flystar233/keyborad/README.md

# BLE Keybrick —— ESP32-C3 智能桌面小键盘

一块 5 键蓝牙快捷键盘的固件。连上电脑或手机后，5 个键发送可切换的快捷键组合，
另外带 OLED 状态屏、5 颗 RGB 灯和锂电池供电。

- **蓝牙 HID 键盘**：免驱，支持普通快捷键和媒体键（音量、播放/暂停等）；基于 NimBLE 协议栈，
  配对信息掉电保存，键盘重启、电脑重启或睡眠唤醒后自动回连
- **5 组键位预设**：随时切换，掉电保存；用本地网页就能改键（USB 或蓝牙都行），不用重新烧录
- **蓝牙串口（NUS）**：不插线也能改键、推送 Claude Code 状态，和 USB 串口用同一套命令
- **OLED 状态屏**（128×32）：电池电量 + 电压、蓝牙状态、按键提示
- **5 颗 WS2812B 灯**：6 种灯效，按键反馈，连接 / 低电状态提示
- **蜂鸣器**：开机 / 连接 / 断开 / 确认提示旋律，按键音，内置彩蛋音乐，三档音量开关
- **锂电池**：电量按放电曲线换算，低电提醒，TP4056 充电
- **Claude Code 状态灯**：电脑上的 Claude Code 在思考、跑工具、等你操作、做完了，键盘屏幕 / 灯 / 蜂鸣器实时提示

硬件依据：原理图 `Schematic1` / `Board1` V1.0（嘉立创 EDA）。许可证：[GPL-3.0](LICENSE)。

---

## 目录

1. [快速上手](#1-快速上手)
2. [按键操作](#2-按键操作)
3. [屏幕](#3-屏幕)
4. [灯效](#4-灯效)
5. [电池](#5-电池)
6. [Claude Code 状态](#6-claude-code-状态)
7. [编译与烧录](#7-编译与烧录)
8. [自定义](#8-自定义)
9. [串口诊断命令](#9-串口诊断命令)
10. [故障排查](#10-故障排查)
11. [硬件与引脚](#11-硬件与引脚)
12. [代码结构](#12-代码结构)
13. [致谢](#13-致谢)
14. [许可证](#14-许可证)

---

## 1. 快速上手

1. **上电**：5 颗灯依次亮 红 → 绿 → 蓝 → 白（自检，约 1 秒），OLED 亮起。
2. **等待配对**：5 颗灯**黄色明暗呼吸** = 正在广播。
3. **配对**：在电脑 / 手机的蓝牙设置里找到 **`ESP32-C3 Keybrick`** 并连接。
4. **连上后**：蜂鸣器"嘀"一声，5 颗灯**绿色闪 2 下后熄灭**，屏幕右上角蓝牙图标旁出现一个实心点。
5. **开始用**：按 K1~K5 发送当前预设的快捷键；按哪个键，哪颗灯亮一下再渐暗，
   屏幕同时显示 1.5 秒按键说明（如 `K1: Ctrl+C`）。

断开后会自动重新广播（约 3~4.5 秒后），灯回到黄色呼吸，主机可以直接回连。

---

## 2. 按键操作

板上一共 6 个按键：

| 按键 | 作用 |
| --- | --- |
| **K1~K5** | 发送当前预设的快捷键（按下立即发送；按住和普通键盘一样会连发，比如按住 Backspace 一直删） |
| **SW1 短按** | 切换灯效（见 [4. 灯效](#4-灯效)） |
| **SW1 长按 1 秒** | 进入 / 退出 **预设切换** 模式（响一声） |
| **K1 / K2（休眠时）** | 唤醒键盘，自动回连（见 [5. 电池 · 自动休眠](#自动休眠)） |

### 2.1 内置的 5 组预设

| # | 预设 | K1 | K2 | K3 | K4 | K5 |
| --- | --- | --- | --- | --- | --- | --- |
| 1 | **Daily** | Ctrl+C 复制 | Ctrl+V 粘贴 | Ctrl+Z 撤销 | PrtSc 截图 | Backspace 退格 |
| 2 | **Win Combos** | Alt+Tab | Win+D 显示桌面 | Ctrl+Alt+Del | — | — |
| 3 | **VSCode** | Ctrl+K+C 注释 | Ctrl+K+U 取消注释 | Ctrl+[ 左缩进 | Ctrl+] 右缩进 | — |
| 4 | **LCEDA**（立创 EDA） | Alt+W 布线 | Alt+V 过孔 | Alt+E 铺铜 | Alt+T 顶层 | Alt+B 底层 |
| 5 | **Media** | 音量 − | 音量 + | 播放 / 暂停 | 静音 | 下一曲 |

`—` 表示空键：按下有灯光和声音反馈，但不发送任何东西。
想改键位见 [8.1 用网页改键](#81-用网页改键)。

### 2.2 切换预设

1. **长按 SW1 1 秒**，听到"嘀"一声进入预设切换模式：5 颗灯整体偏青色，
   屏幕显示 `> Config Preset` 和当前预设名，下方每 2 秒滚动显示各键说明。
2. **K1 / K2** 上一组 / 下一组（按住可以连续翻页）。翻到的预设**立即生效**，可以直接试按。
3. **K3 确认**：保存到 flash（断电不丢），"叮咚"一声回到正常模式。

预设切换模式下另外两个键：

| 键 | 作用 |
| --- | --- |
| **K4** | 声音档位：全开 → 关按键音 → 静音 → 全开（立即保存，见 [2.3](#23-声音)） |
| **K5** | 播放彩蛋音乐，《欢乐颂》（约 21 秒）《卡农》快速段（约 22 秒）轮流；放的时候再按一下停止 |

不确认就退出（再次长按 SW1，或串口 `n`），会**恢复成进来之前的预设**。
预设切换模式下按键**不会**向电脑发送快捷键。

### 2.3 声音

| 场合 | 声音 |
| --- | --- |
| 开机 | do-mi-sol-do 上行 |
| 蓝牙连上 / 断开 | 上扬两音 / 下沉三音 |
| 进入预设切换 / 不确认退出 | 短促上行 / 短促下行 |
| 确认预设 | "叮咚" |
| 按 K1~K5 发送快捷键 | 很短的"嗒" |
| 预设切换模式按 K5 | 彩蛋音乐（见下表） |

彩蛋音乐（预设切换模式下按 K5 轮流播放，播放中再按一次停止）：

| 曲子 | 时长 | 内容 | 音域 |
| --- | --- | --- | --- |
| 《欢乐颂》 | 约 21 秒 | 完整主题四句 A - A' - B - A' | 784~1568Hz |
| 《卡农》 | 约 22 秒 | 第一小提琴声部的十六分音符快速段，放慢后完整重复两遍，收在主音 D | 587~1760Hz |

声音档位（预设切换模式按 K4 切换，屏幕第 1 行显示 `Sound:ON / QUIET / OFF`）：

| 档位 | 按键音 | 提示旋律 | 彩蛋音乐 |
| --- | --- | --- | --- |
| `ON`（默认） | ✓ | ✓ | ✓ |
| `QUIET` | — | ✓ | ✓ |
| `OFF` | — | — | — |

蜂鸣器是无源电磁式（QMB-09B-03，谐振约 2.7kHz），只能放单音旋律、音色是电子方波音。
它在 1~4kHz 最响、低于 1kHz 会稍微发闷，太高又刺耳，所以曲子都放在 600~1800Hz 左右。

改曲子都在 `src/buzzer.cpp`：

- **快慢**：`ODE_Q`（欢乐颂，330）和 `CANON_Q`（卡农，600）是四分音符的毫秒数，越大越慢、曲子也越长。
- **卡农只放一遍**：删掉 `kCanon` 里第二个 `CANON_PASSAGE,`（约 13 秒）。
- **加新曲子**：照 `kOdeToJoy` 的格式写一个 `{频率, 毫秒}` 数组，再加进 `kSongs[]`，K5 就会轮到它。

---

## 3. 屏幕

### 正常模式

平时只有顶部一行状态，其余留空：

```
[电池] 3.87V                              [蓝牙]●

 K1: Ctrl+C          ← 按键时显示 1.5 秒
Claude Bash      1:23 ← Claude Code 状态（见 6. Claude Code 状态）
```

| 元素 | 说明 |
| --- | --- |
| 电池图标（左上） | 5 档填充表示电量；**空心** = 未启用电池检测（见 [5. 电池](#5-电池)） |
| 电压（图标右侧） | 如 `3.87V`，每 10 秒更新；读不到时显示 `-.--V`；未启用电池检测时不显示 |
| 蓝牙图标（右上） | 只有图标 = 等待配对；图标 + 右侧实心点 = 已连接 |
| 按键提示（第 3 行） | 按 K1~K5 时显示键名和功能，1.5 秒后消失 |
| Claude 状态（第 4 行） | 电脑上 Claude Code 的运行状态 + 本轮用时；没在用时不显示 |

### 预设切换模式

第 1 行 `> Preset  Sound:ON`（带当前声音档位），第 2 行 `< 预设名 >`，第 3、4 行轮流显示 5 个键的说明（每 2 秒滚动）。

### 息屏

- 无操作 20 秒变暗，30 秒关屏；按任意键（包括 SW1）唤醒。
- 低电时强制变暗省电。

---

## 4. 灯效

### 状态提示（优先于灯效模式）

| 状态 | 灯 |
| --- | --- |
| 上电自检 | 红 → 绿 → 蓝 → 白，各 250ms |
| 未连接蓝牙（上电、广播中、断线后） | 5 颗一起**黄色明暗呼吸** |
| 刚连上蓝牙 | 5 颗一起**绿色闪 2 下**，然后进入当前灯效 |
| 预设切换模式 | 整条偏**青色** |
| 电池低电 | 整条**暗红闪烁**（最高优先级） |

### 灯效模式（6 种）

**短按 SW1** 切换到下一种（松开时生效）。上电默认第 1 种，不保存。

| # | 名称 | 效果 |
| --- | --- | --- |
| 1 | `KEYS`（默认） | 全灭；按下的键对应的灯**亮一下再渐暗** |
| 2 | `WHITE` | 白色常亮 |
| 3 | `BREATHE` | 青蓝色整条呼吸 |
| 4 | `RAINBOW_CHASE` | 炫彩跑马灯：一颗亮点来回跑、边跑边换色，带拖尾 |
| 5 | `RAINBOW` | 彩虹流动：整条色轮缓慢平移 |
| 6 | `KEYS_COLOR` | 缤纷按键：全灭；按键时亮一个随机颜色再渐暗 |

- **按键反馈**在所有灯效下都有：平时是白色，`WHITE` 灯效下为青色，`KEYS_COLOR` 下为随机色。
- 未连接蓝牙时切换灯效，会先**预览新灯效 3 秒**再回到黄色呼吸。
- 切换灯效不会改变屏幕内容。
- **省电**：5 颗灯全灭超过 1 分钟，自动切断灯珠电源（GPIO21）；之后一有要亮的灯（按键、连接状态、切灯效等）自动重新上电，只多 5ms 延迟。

---

## 5. 电池

### 显示

- **电量**按锂电池放电曲线查表换算（不是线性），参考点：

  | 电压 | 4.20V | 4.00V | 3.87V | 3.80V | 3.75V | 3.70V | 3.60V | 3.40V |
  | --- | --- | --- | --- | --- | --- | --- | --- | --- |
  | 电量 | 100% | 80% | 60% | ≈43% | ≈27% | ≈14% | 5% | 0% |

  锂电池的"3.7V 标称"是整个放电过程的平均电压，不代表还剩一半电。
  空电点取 3.40V：板上 LDO 输出 3.3V，电池再低，系统供电就不稳了。

- **低电**：低于 3.50V 进入（灯暗红闪、屏幕变暗），回升到 3.60V 以上才解除。
- 电量同时通过蓝牙电池服务上报给主机。

### 自动休眠

电源开着但**蓝牙 1 分钟都没连上、也没人按键**时，屏幕提示 `Sleeping...` 后进入深度睡眠：
灯、屏幕、蓝牙全关，省得忘了拨电源开关时一直亮灯耗电。

- **按 K1 或 K2 唤醒**，醒来自动回连电脑（不放开机音、不跑灯效自检，回连更快）。
  只有这两个键能唤醒：ESP32-C3 只有 GPIO0~5 能把芯片从深度睡眠里叫醒。
- 连着蓝牙、或者 USB 插在电脑上（改键、看日志时）不会睡；只插充电器不算，照样会睡（睡着也照常充电）。
- 时间和开关在 `include/board_config.h`：`AUTO_SLEEP_MS`（默认 60 秒）、`AUTO_SLEEP_ENABLED`。

### 充电时读数偏高

电压是在 BAT+ 上测的。充电时充电电流会在电池内阻上产生额外压降，
所以显示的电压和电量**偏高**（比如静置 3.70V 的电池充电时可能显示 3.80V 左右，接近充满时停在约 4.2V）。
拔掉充电线静置一会儿后的读数才准确。

### 启用 / 停用电池检测

TP4056 在**没装电池**时也会让 BAT+ 一直保持 4.2V，软件无法区分"没装电池"和"已充满"。
所以用开关明确告诉固件有没有装电池：

| 方式 | 用法 |
| --- | --- |
| `include/board_config.h` | `#define BATTERY_PRESENT 1`（装了电池，默认）/ `0`（没装） |
| 运行时 | 串口发 `v` 来回切换（重启后恢复为上面的设定） |

停用时不采样，电池图标为空心、不显示电压，也不会误报低电。

### 校准

如果显示的电压和万用表实测不一致，调 `board_config.h` 里的 `BATTERY_CAL`：
`显示电压 = ADC 读数 / 0.5 × BATTERY_CAL`。

---

## 6. Claude Code 状态

在电脑上用 [Claude Code](https://claude.com/claude-code) 时，键盘会实时显示它在干什么，
让你不用一直盯着终端：

| Claude Code 在 | 屏幕第 4 行 | 灯 | 声音 |
| --- | --- | --- | --- |
| 刚打开 | `Claude ready` | — | — |
| 思考 | `Claude thinking  0:12`（本轮已用时） | — | — |
| 调用工具 | `Claude Bash 0:15`（工具名） | — | — |
| **等你操作**（批准权限、回答问题、确认计划） | `Claude NEED YOU` 闪烁 | **K5 那颗灯橙色闪** | 嘀嘀嘀 |
| **做完了** | `Claude done 2:47`（本轮总用时） | K5 那颗灯绿闪 3 下 | 三音上行 |
| 你中途打断（Esc / 停止 / 拒绝权限并打断） | 回到 `Claude ready` | 灯停 | — |
| 关闭 | 不显示 | — | — |

- "做完了"会保留 10 分钟，之后变回 `Claude ready`。
- 声音受声音档位控制（[2.3](#23-声音)），`OFF` 档不响。
- 只在正常模式的屏幕上显示；状态变成"等你 / 做完"时会自动点亮屏幕。

### 工作原理

Claude Code 的 **hooks**（事件钩子）在每次提交提示词、调用工具、请求权限、完成时，
运行 `tools/claude_status.py`。脚本把事件换成一行 `@CLAUDE <状态> [工具名]`，
发给键盘：**插着 USB 线就走 USB 串口，没插线就走蓝牙**。工具调用的钩子在后台运行，**不会拖慢 Claude Code**；
USB 和蓝牙都找不到键盘时脚本直接安静退出。

**走蓝牙时**：第一次需要时脚本会在后台起一个"蓝牙桥"小进程，一直连着键盘的蓝牙串口（NUS），
之后每个钩子只是把一行交给它，约 0.2 秒送达（改键网页的「蓝牙连接」在电脑上也走这个桥，本机端口 47815）。桥刚启动、还没连上时（约 5 秒）只记住最新一条，
连上立刻补发。断开会自动重连，2 小时没有消息自己退出。蓝牙需要 Python 库 `bleak`（安装脚本会自动装）。

### 安装（任何一台电脑，一条命令）

支持 Windows / macOS / Linux。需要：装了 Claude Code、有 Python 3.7+，键盘用 USB 数据线连着这台电脑，
**或者**已经和这台电脑蓝牙配对。

1. 把 `tools/claude_status.py` 和 `tools/install_claude_status.py` 这两个文件拷到那台电脑（放同一个目录）。
2. 运行：

   ```bash
   python install_claude_status.py          # macOS / Linux 上可能是 python3
   ```

安装脚本会：

1. 检查 pyserial（USB 用，必需）和 bleak（蓝牙用，可选），没有就自动安装；
2. 把 `claude_status.py` 复制到 `~/.claude/keybrick/`（装完后那两个文件可以删掉）；
3. 把 7 个钩子合并进 `~/.claude/settings.json`：只增删本工具自己的条目，其它设置和别的钩子原样保留，
   改之前备份成 `settings.json.bak-keybrick`，重复运行不会重复添加；
4. 给键盘发一遍测试状态（thinking → Test → NEED YOU → done），确认能收到。

装完 Claude Code 不用重启，下一次事件就生效。

| 命令 | 作用 |
| --- | --- |
| `python install_claude_status.py` | 安装或更新（改了 `claude_status.py` 后重新运行一次即可） |
| `python install_claude_status.py --test` | 只发一遍测试状态 |
| `python install_claude_status.py --uninstall` | 卸载：删掉钩子和 `~/.claude/keybrick/` |

钩子在 `settings.json` 里长这样（安装脚本自动写，一般不用手动改）：

```json
"Stop": [{ "hooks": [{ "type": "command", "command": "<python 路径>",
                       "args": ["~/.claude/keybrick/claude_status.py"], "timeout": 15 }] }]
```

工具事件（`PreToolUse` / `PostToolUse`）额外带 `"async": true`、`"matcher": "*"`。

- **手动测试**：`python ~/.claude/keybrick/claude_status.py work`（也可以是 `tool Bash` / `wait` / `done`），会打印键盘的回复。
- **指定串口**：默认自动找乐鑫（VID 0x303A）的串口；有多块板子时设环境变量 `KEYBRICK_PORT`
  （Windows 如 `COM3`，macOS 如 `/dev/cu.usbmodem1101`）。
- **Linux 串口权限**：`sudo usermod -aG dialout $USER`，重新登录后生效。
- **暂时关掉**：Claude Code 里输入 `/hooks` 可以查看、停用这些钩子。
- **注意**：改键网页或串口监视器开着时 USB 串口被占用，这期间会自动改走蓝牙（如果配对过）。
- **只用 USB**：设环境变量 `KEYBRICK_BLE=0` 关掉蓝牙。
- **打断检测**：Claude Code 被打断时不会触发"完成"事件，所以每次提交提示词时会在后台起一个小进程，盯着这个会话的记录文件，看到打断记录就把键盘切回 `Claude ready`；这一轮正常结束或下一轮开始时它自动退出。
- **排查**：每次发送都记在临时目录的 `keybrick_claude.log`（Windows 是 `%TEMP%\keybrick_claude.log`），
  记录事件、状态、走的通道（`COMx` 或 `ble`）、是否被丢弃、耗时；蓝牙桥的连接 / 断开也记在这里。
- **顺序保证**：多个钩子进程按"进程创建时刻"排队发送，晚到的旧消息直接丢弃；
  "开始 / 提交 / 等你 / 完成 / 关闭"这几个钩子同步运行，保证一定送到，工具事件在后台运行不拖慢 Claude Code。

---

## 7. 编译与烧录

### 环境

- [PlatformIO](https://platformio.org/)（VS Code 插件或命令行）
- 工具链：`espressif32@6.10.0`（arduino-esp32 2.0.17），首次编译会自动下载
- 蓝牙库：[NimBLE-Arduino](https://github.com/h2zero/NimBLE-Arduino) 2.x（`platformio.ini` 的 `lib_deps`），首次编译会自动下载
- 板子用 USB-C 直接连电脑（芯片内置 USB-Serial/JTAG，无需 USB 转串口芯片）

### 命令（在项目根目录执行）

```powershell
# 只编译
pio run

# 编译 + 烧录（自动找串口）
powershell -NoProfile -ExecutionPolicy Bypass -File tools\flash.ps1

# 指定串口 / 跳过编译
powershell -NoProfile -ExecutionPolicy Bypass -File tools\flash.ps1 -Port COM16
powershell -NoProfile -ExecutionPolicy Bypass -File tools\flash.ps1 -Port COM16 -SkipBuild

# 看日志（115200）
pio device monitor --port COM16 --dtr 0 --rts 0
```

如果 `pio` 不在 PATH 里，用完整路径 `$env:USERPROFILE\.platformio\penv\Scripts\pio.exe`。

> **必须用 `tools\flash.ps1` 烧录，不要用 `pio run -t upload`**：后者在这块板上会报
> `Wrong boot mode detected (0xd)`（固件运行时 esptool 默认的复位方式进不了下载模式，脚本改用 `--before usb_reset`）。
>
> **看日志必须带 `--dtr 0 --rts 0`**，否则打开串口会让芯片复位或停在下载模式。

**进不了下载模式时**（极少见）：按住 **BOOT** → 点一下 **RESET** → 松开 BOOT，
然后执行 `tools\flash.ps1 -SkipReset`。

### 资源占用

RAM 约 8%（26KB / 320KB），Flash 约 41%（526KB / 1280KB）。
蓝牙协议栈换成 NimBLE 后 Flash 少了一半左右（之前用 Bluedroid 约 79%），加功能的余量很充足。

---

## 8. 自定义

### 8.1 用网页改键

`tools/keymap.html` 是一个本地网页，通过 USB 或蓝牙直接读写键盘上的 5 组预设，**不用重新烧录**。

1. 用 **Chrome 或 Edge** 双击打开 `tools/keymap.html`（其它浏览器不支持 Web Serial / Web Bluetooth）。
2. 二选一连接键盘：
   - **USB 连接**：插上 USB 线，**关掉** PlatformIO 串口监视器等占用串口的程序，点右上角「USB 连接」，
     在列表里选 `USB JTAG/serial debug unit`（或带 `COMx` 的那一项）。
   - **蓝牙连接**：键盘先和这台电脑配对好（正常当键盘用的状态就行），点右上角「蓝牙连接」。
     电脑上要经过本机的**蓝牙桥**（和 Claude Code 状态推送是同一个后台进程）：装了状态推送的话没插线时会自动启动；
     也可以手动运行 `python tools/claude_status.py --ble-bridge`（需要 `pip install bleak`）。
     安卓手机上的 Chrome 直接用浏览器自带的蓝牙，在列表里选 `ESP32-C3 Keybrick`。
     > 为什么电脑上不直接用浏览器的蓝牙：Windows 把键盘当成 HID 设备占用着，浏览器的 Web Bluetooth
     > 连它时会强制重新查询服务列表，这一步会失败（报找不到 `6e400002...` 特征值）。
3. 顶栏状态会显示"已连接（USB）"或"已连接（蓝牙）"。
4. 页面自动读出 5 组预设，并显示键盘当前正在用的那一组。点模型左上角的圆钮 **1~5**
   切换预设，键盘会同步切过去（圆钮下方的短横线标出键盘当前用的是哪组）。选好一组后可以修改：
   - **预设名**（≤19 个英文字符）和**类型**（普通快捷键 / 媒体键）
   - 每个键的**修饰键**（Ctrl / Shift / Alt / Win）+ **按键**（最多两个，如 Ctrl+K+C）；
     也可以点 **录制**，然后直接在电脑键盘上按组合键
   - 媒体键：音量、播放 / 暂停、上一曲 / 下一曲、静音、计算器、浏览器后退等
   - 按键时 OLED 上显示的说明按组合键自动生成（如 `Ctrl+Shift+S`、`Volume +`），不用单独填
5. 点 **写入键盘**：5 组一起写入并保存到 flash，立即生效，断电不丢。

其它按钮：**恢复出厂预设**、**导出到文件 / 从文件导入**（备份或分享键位）。
有改动但还没写入的预设，对应圆钮右上角会有一个橙色圆点；右上角「写入键盘」按钮上显示未写入的组数。

> - 屏幕字体只有英文字符，预设名和说明里不能用中文。
> - 有些组合键会被浏览器或系统先拦截（如 Ctrl+W、Alt+Tab、Win+D），录制不到；用下拉框手动选即可。
> - 按键码只能用标准键盘区和小键盘（F1~F12 以内），F13 以上键盘发不了。
> - 如果双击打开后点"连接键盘"没反应，可以在 `tools` 目录下运行 `python -m http.server 8000`，
>   再用浏览器打开 `http://localhost:8000/keymap.html`。

### 8.2 在源码里改出厂预设

出厂预设（以及"恢复出厂预设"恢复成的样子）在 `src/settings.cpp` 的 `kDefaultPresets[]`。
每个键是一条 8 字节的 HID 键盘报文：

```
{ 修饰键, 0x00, 键码1, 键码2, 0x00, 0x00, 0x00, 0x00 }
```

| 修饰键（可相加） | 值 |
| --- | --- |
| 左 Ctrl | `0x01` |
| 左 Shift | `0x02` |
| 左 Alt | `0x04` |
| 左 Win / Cmd | `0x08` |

常用键码：`A`~`Z` = `0x04`~`0x1D`，`1`~`9` = `0x1E`~`0x26`，`0` = `0x27`，
Enter `0x28`，Esc `0x29`，Backspace `0x2A`，Tab `0x2B`，空格 `0x2C`，
F1~F12 = `0x3A`~`0x45`，Delete `0x4C`，方向键 → ← ↓ ↑ = `0x4F`~`0x52`。
完整列表见 USB HID Usage Tables 的 Keyboard/Keypad Page (0x07)。

例：Ctrl+Shift+T = `{ 0x03, 0x00, 0x17, 0x00, 0x00, 0x00, 0x00, 0x00 }`。

每组预设还要填：
- `name`：预设名（≤19 字符，显示在屏幕上）
- `keyDesc`：5 个键的说明（每个 ≤15 字符，按键时显示在屏幕上）
- 全 0 的报文 = 空键

**媒体键**：把预设最后的 `isMedia` 设为 `true`，每个键第 0 字节填媒体键位：
`MEDIA_VOLUME_UP` / `MEDIA_VOLUME_DOWN` / `MEDIA_PLAY_PAUSE` / `MEDIA_MUTE` /
`MEDIA_NEXT_TRACK` / `MEDIA_PREV_TRACK` / `MEDIA_STOP`（定义在 `include/settings.h`）。
一组预设要么全是普通键，要么全是媒体键。

增减预设数量时，同步改 `include/settings.h` 的 `PRESET_COUNT`。

### 8.3 常用参数

| 参数 | 位置 | 默认 |
| --- | --- | --- |
| 灯珠亮度 `LED_BRIGHTNESS`（0~255） | `include/board_config.h` | 96 |
| 蓝牙设备名 `BLE_DEVICE_NAME` | `include/board_config.h` | `ESP32-C3 Keybrick` |
| 是否装了电池 `BATTERY_PRESENT` | `include/board_config.h` | 1 |
| 低电阈值 `BAT_LOW_V` / `BAT_LOW_RELEASE_V` | `include/board_config.h` | 3.50V / 3.60V |
| SW1 长按时间 `MODE_HOLD_MS` | `src/system.cpp` | 1000ms |
| 翻页连发延迟 / 间隔 | `include/buttons.h` | 450ms / 140ms |
| 变暗 / 关屏时间 | `src/system.cpp` | 20s / 30s |
| 提示旋律 / 彩蛋曲子 | `src/buzzer.cpp` | 见 [2.3 声音](#23-声音) |
| 电量曲线 `kBatCurve` | `src/battery.cpp` | 见 [5. 电池](#5-电池) |

修改引脚只需要改 `include/board_config.h`，其它文件不涉及具体引脚号。

---

## 9. 串口诊断命令

用 `pio device monitor --port COMx --dtr 0 --rts 0` 打开串口后，**单键输入，不需要回车**。
每次只按一个键：一次收到多个字符（比如粘贴一串、或带回车）会被当成杂讯丢弃，防止误触发。

| 键 | 作用 |
| --- | --- |
| `?` | 显示帮助 |
| `@...` | 网页改键、Claude 状态用的行协议（见 `src/system.cpp` 的"上位机改键协议"注释），手动一般用不到。蓝牙串口（NUS）也能发同样的命令，单键诊断命令只走 USB |
| `s` | 打印状态：模式、预设、电压 / 电量、屏幕、声音档位、灯珠电源 |
| `1`~`5` | 直接切换到第 N 组预设并保存 |
| `p` | 打印当前预设 5 个键的 HID 报文字节 |
| `n` / `c` | 切到 正常 / 预设切换 模式 |
| `v` | 切换"是否装了电池" |
| `e` / `k` | 切换下一个灯效 / 查看当前灯效和 SW1 按键状态 |
| `r` | 重跑灯珠自检（红绿蓝白） |
| `x` | 逐颗逐通道检测：每颗灯依次只亮 红 / 绿 / 蓝 / 白 |
| `o` / `f` | 灯珠电源 开 / 关（用万用表量灯珠供电时用） |
| `i` | 扫描 I2C 总线（排查屏幕不亮） |
| `d` | 屏幕探活，并冻结画面显示状态行 + 四角定位点 |
| `F` | 解除 / 恢复屏幕冻结 |
| `P` | 自动模拟 5 个键的按键提示，检查文字位置 |
| `w` | 唤醒屏幕 |
| `g` | 打印 GPIO 矩阵：每个脚当前由哪个外设驱动 |

`g` 输出中 `out_sel` 的含义：`128` = 普通 GPIO 输出，`51` = RMT（灯珠数据），
`45` = LEDC（蜂鸣器），`6` = UART0 TXD。正常时灯珠数据脚（pin1）是 `51`，灯珠电源脚（pin21）是 `128`。

> 启动日志（`=== ESP32-C3 BLE Keybrick booting ===`）只有在复位后**立刻**打开串口才看得到。
> 日志在主机没读时最多等 20ms 就丢弃，这是为了不阻塞按键和灯效。

---

## 10. 故障排查

| 现象 | 排查 |
| --- | --- |
| 烧录报 `Wrong boot mode detected` | 用 `tools\flash.ps1`，不要用 `pio run -t upload`；仍不行就手动进下载模式（见 [7](#7-编译与烧录)） |
| 串口没有任何输出 | 确认带了 `--dtr 0 --rts 0`；复位后马上打开串口；发 `?` 看有没有回应 |
| 搜不到蓝牙设备 | 灯是不是黄色呼吸（在广播）；电脑上删除旧的配对记录后重新搜索 |
| 蓝牙反复连上又断开 | 电脑上的配对记录和键盘对不上（比如从旧固件升级后）：在电脑蓝牙设置里删除 `ESP32-C3 Keybrick` 再重新添加。串口日志里会看到 `link up ... encrypted=0` 后紧跟 `link down` |
| 网页点"连接键盘"列表里没有设备 | 换一根能传数据的 USB 线；确认用的是电脑版 Chrome / Edge |
| 网页提示"打不开串口" | 串口被占用：关掉 PlatformIO 串口监视器、Arduino IDE 等 |
| 网页提示"键盘没有回应" | 固件太旧，先用 `tools\flash.ps1` 烧录最新固件 |
| 网页点「蓝牙连接」提示要启动蓝牙桥 | 运行 `python tools/claude_status.py --ble-bridge`（需要 bleak），等几秒再点；或者插线用「USB 连接」 |
| 网页提示蓝牙桥还没连上键盘 | 键盘要开着、并且已经在系统蓝牙设置里配对；刚启动的桥要几秒才连上 |
| 能连上但按键没反应 | 是否在正常模式（灯不偏青、屏幕只有状态行）；当前预设的这个键是不是空键（`p` 查看） |
| 灯全不亮 | 串口 `g`：pin21 `out_sel` 应为 `128`；量灯珠供电是否 3.3V（`o`/`f` 切换时应跟着变） |
| 只有第 1 颗灯亮 | LED1 `DO` → LED2 `DI` 之间断开（虚焊或方向） |
| 某颗灯颜色偏黄 / 偏色 | 发 `x` 逐通道检测；某个通道不亮就是那颗灯坏了或虚焊（黄色 = 蓝通道不亮） |
| 红绿颜色反了 | 改 `src/ws2812.cpp` 中 `show()` 的 `order[3] = {1,0,2}` |
| 屏幕不亮 | 串口 `i`：扫到 `0x3C` 说明屏幕在线；什么都扫不到就检查排针 3V3 / GND / SDA / SCL |
| K3 没反应 / 灯全灭 | 检查 `platformio.ini` 中 `ARDUINO_USB_CDC_ON_BOOT=1` 是否还在（K3 / GPIO20 和灯珠电源 / GPIO21 是 UART0 默认引脚，日志必须走 USB） |
| 上电时按键乱触发 / 进了下载模式 | GPIO0 / 2 / 8 / 9 是启动配置脚，上电瞬间不要按住 K1 / K2 / K5 / BOOT |
| 电压和万用表不一致 | 调 `BATTERY_CAL`（见 [5](#5-电池)） |
| 没装电池却显示 4.2V / 100% | 把 `BATTERY_PRESENT` 设为 0，或串口发 `v` |

---

## 11. 硬件与引脚

| 功能 | 引脚 | 说明 |
| --- | --- | --- |
| K1 | GPIO0 | 按下接地，内部上拉；启动配置脚 |
| K2 | GPIO2 | 按下接地，板上 10K 上拉；启动配置脚 |
| K3 | GPIO20 | 按下接地，内部上拉；同时是 UART0 RXD 默认脚 |
| K4 | GPIO7 | 按下接地，内部上拉 |
| K5 | GPIO8 | 按下接地，板上 10K 上拉；启动配置脚 |
| SW1（灯效 / 模式键） | GPIO6 | 按下接地，内部上拉 |
| WS2812B 数据 | GPIO1 | 经 100Ω 接 LED1，5 颗级联（WS2812B-2020） |
| 灯珠电源开关 | GPIO21 | AO3401 P-MOS 高边开关，**低电平导通**；灯全灭 1 分钟自动断电省电；同时是 UART0 TXD 默认脚 |
| OLED SDA / SCL | GPIO4 / GPIO5 | SSD1306 128×32，硬件 I2C 400kHz，地址 `0x3C` |
| 蜂鸣器 | GPIO10 | 经 S9013 驱动的 2.7kHz 无源蜂鸣器，高电平响 |
| 电池电压 | GPIO3 | BAT+ 经 100K/100K 分压（×0.5），只能作模拟输入 |
| BOOT | GPIO9 | 只用于进下载模式 |
| USB | GPIO18 / GPIO19 | 芯片内置 USB-Serial/JTAG，烧录和日志都走这里 |

电源：TP4056 充电（500mA），TLV75733 LDO 输出 3.3V。
外壳：3D 打印，壳体 + 盖子用 4 颗 M2×14 自攻螺丝从底部固定，见 [case/README.md](case/README.md)。
除 GPIO9（BOOT）外，所有可用引脚都已占用。

---

## 12. 代码结构

```
platformio.ini            工程配置
include/board_config.h    所有引脚与硬件参数（改硬件只改这里）
src/main.cpp              启动流程 + 主循环：蓝牙连接、报文发送、各模块调度
src/system.cpp            模式切换、按键与 SW1 事件、OLED 界面、串口诊断命令、改键协议（USB / 蓝牙两个通道）
src/buttons.cpp           K1~K5 消抖与连发（非阻塞）
src/settings.cpp          出厂预设表 + 用户预设的 NVS 读写
src/display.cpp           SSD1306 驱动：512 字节帧缓冲、6×8 字体、图标
src/led_effects.cpp       灯效与状态提示的合成，SW1 消抖
src/ws2812.cpp            WS2812B 驱动（RMT 硬件时序）+ 灯珠电源开关
src/buzzer.cpp            蜂鸣器：LEDC 硬件 PWM + 非阻塞音符播放器、提示旋律、彩蛋曲子
src/battery.cpp           电池电压采样、电量换算、低电判断
include/usb_log.h         直接写 USB-Serial/JTAG FIFO 的日志
include/display_font.h    6×8 ASCII 字库
include/display_icons.h   电池 / 蓝牙 8×8 图标（取自 u8g2 open-iconic）
lib/ble_keyboard/         BLE HID 键盘 + 媒体键 + 电池电量 + NUS 蓝牙串口（基于 NimBLE-Arduino）
tools/flash.ps1           烧录脚本
tools/keymap.html         网页改键工具（Chrome / Edge，Web Serial 或 Web Bluetooth）
tools/claude_status.py    Claude Code hook：把运行状态推给键盘（USB 优先，没插线走蓝牙桥）
tools/install_claude_status.py  一键安装 / 卸载上面这个 hook（任何电脑）
tools/verify_icons.py     图标位图校验脚本
case/build_case.py        3D 打印外壳生成脚本（参数化，见 case/README.md）
case/out/                 生成好的外壳 STL（壳体 + 盖子）
case/ref/                 底稿：v1.2f 旧版外壳 STL + PCB 图（外壳开孔位置都按它测量）
```

所有模块都是非阻塞的：主循环每轮轮询各模块后让出 1ms，不使用硬件定时器中断。

---

## 13. 致谢

- 本项目基于一个开源的 ESP32-C3 蓝牙小键盘工程重写。原工程提供了最初的思路、
  6 组键位预设、6×8 ASCII 字库（`include/display_font.h`）和 BLE HID 库（`lib/ble_keyboard/`，
  后来改用 NimBLE 重写，保留了原来的 HID 报告描述符）。代码注释里的"原工程"指的就是它。
- 电池和蓝牙图标取自 [u8g2](https://github.com/olikraus/u8g2) 附带的
  [Open Iconic](https://github.com/iconic/open-iconic) 字形。
- 网页改键使用浏览器的 [Web Serial API](https://developer.mozilla.org/docs/Web/API/Web_Serial_API)。

## 14. 许可证

本项目以 [GNU General Public License v3.0](LICENSE) 发布：可以自由使用、修改和再分发，
但基于本项目发布的修改版也必须以 GPL-3.0 开源。
