flystar233/keyborad/diag/cand2.png

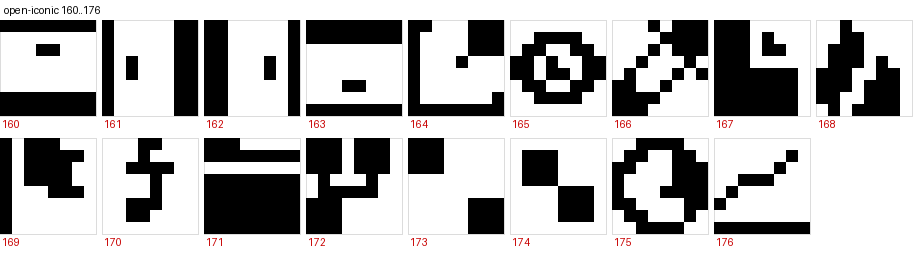
diag/cand2.png
