flystar233/keyborad/diag/cand3.png

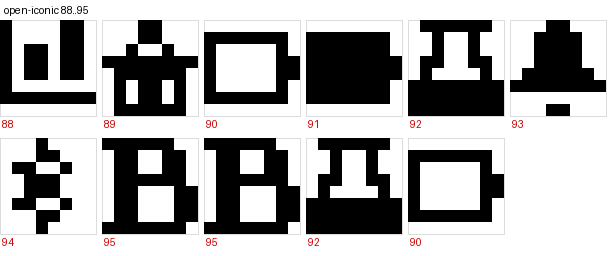
diag/cand3.png
