flystar233/keyborad/diag/candidates.png

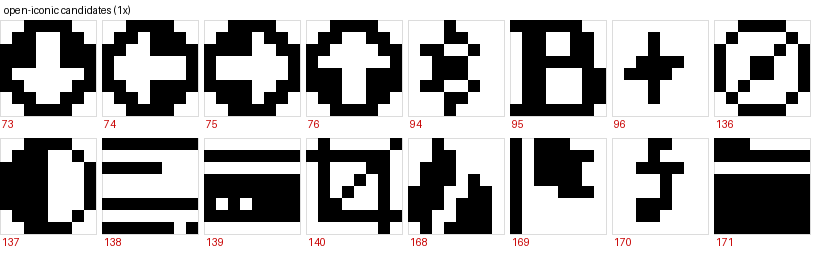
diag/candidates.png
