flystar233/keyborad/diag/T3_buzzer.png

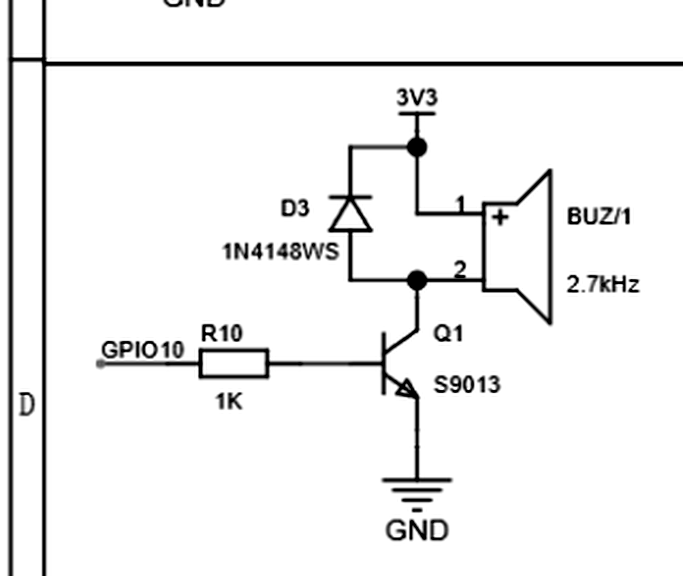
diag/T3_buzzer.png
