flystar233/keyborad/diag/T4_oled.png

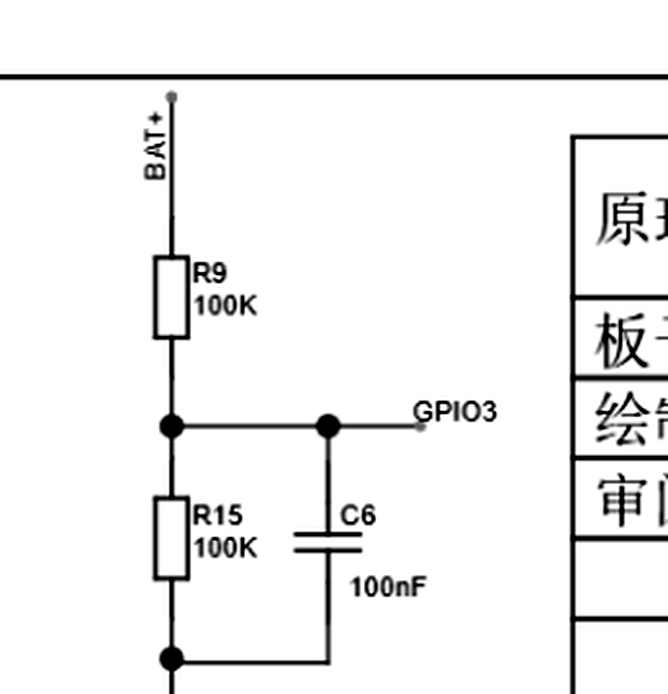
diag/T4_oled.png
