flystar233/keyborad/case/out/ESP32 BLE Keyboard v1.3 cover.stl

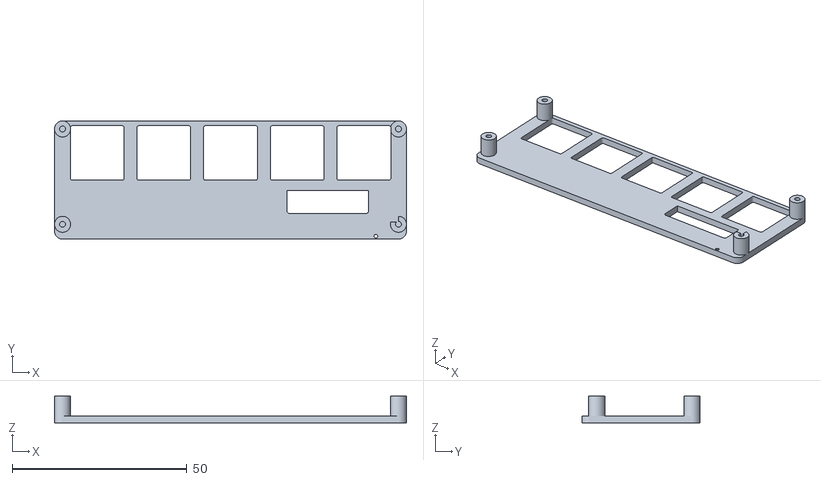
[picture p6: CAD file, 2026-10-12]
case/out/ESP32 BLE Keyboard v1.3 cover.stl
100.8 x 33.9 x 7.70
