flystar233/keyborad/case/out/ESP32 BLE Keyboard v1.3 shell.stl

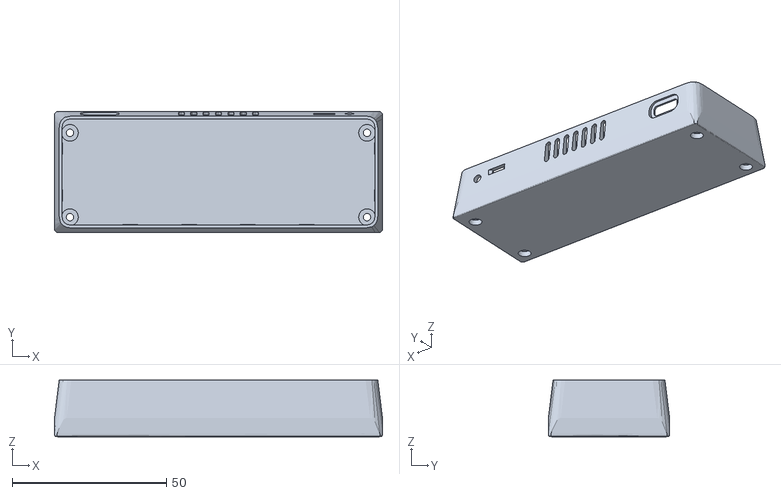
[picture p7: CAD file, 2026-10-12]
case/out/ESP32 BLE Keyboard v1.3 shell.stl
106.2 x 39.3 x 18.3
