flystar233/keyborad/case/ref/PCB_PCB1_2026-10-11.pdf

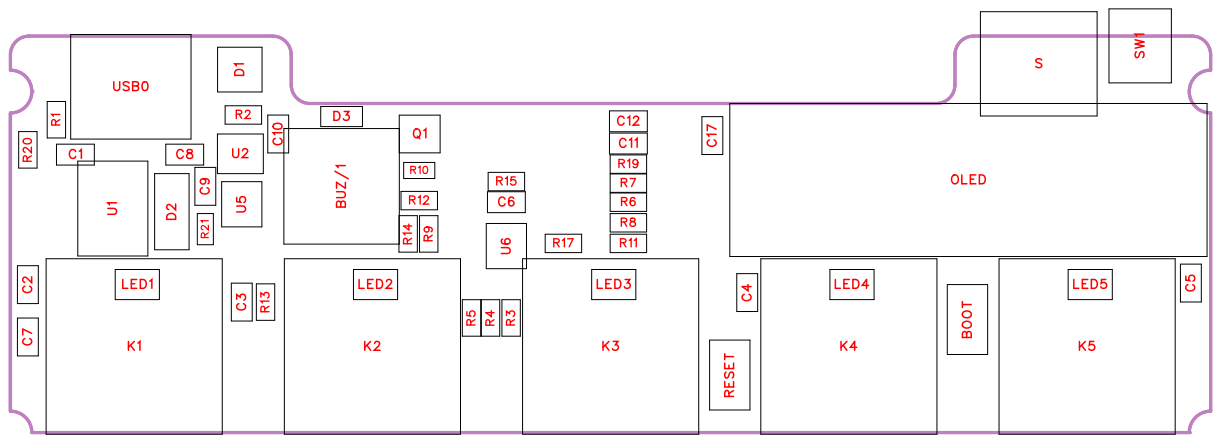
[picture p8: page 1]

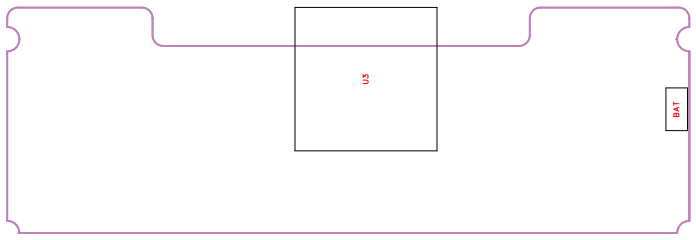
[picture p9: figure]
BAT

No. | Quantity | Comment | Designator | Footprint | Value | Manufacture r Part | Manufacture r | Supplier Part | Supplier
1 | 1 | 2.54-1*2PÍ | BAT | HDR-TH_2P-P 2.54-V-F | | 2.54-1*2PÍ | BOOMELE(ZF¾) Tj | T* (Æ) C49661 | LCSC
2 | 2 | TS-1088-AR0 2016 | BOOT,RESET | SW-SMD_L3.9 -W3.0-P4.45 | | | XUNPU(¯n) | C720477 | LCSC
3 | 1 | 2.7kHz | BUZ/1 | BUZ-TH_BD9. 0-P4.00-D0. 6-FD | 2.7kHz | QMB-09B-03 | Ný | C96256 | LCSC
4 | 4 | 10uF | C1,C7,C10,C11 | C0603 | 10uF
5 | 7 | 100nF | C2,C3,C4,C5,C6,C8,C12 | C0603 | 100nF
6 | 1 | 22uF | C9 | C0603 | 22uF
7 | 1 | 1uF | C17 | C0603 | 1uF
8 | 1 | USBLC6-2SC6D1 | | SOT-23-6_L2 .9-W1.6-P0. 95-LS2.8-BL | | USBLC6-2SC6UMW(ËðJüS) | | C2687116 | LCSC
9 | 1 | SS34 | D2 | SMA_L4.3-W2 .6-LS5.0-FD | | SS34 | R+O(• Ú) | C7420365 | LCSC
10 | 1 | 1N4148WS | D3 | SOD-323_L1. 8-W1.3-LS2. 5-RD | | 1N4148WS | MDD(°¾JüS) | C437156 | LCSC
11 | 5 | :° . tS | K1,K2,K3,K4,K5 | ØyÆt
12 | 5 | WS2812B-202 0-V6 | LED1,LED2,LED3,LED4,LED5LED-SMD_4P- | L2.2-W2.0-P 1.00_WS2815 C-2020-4P | | WS2812B-202 0-V6 | worldsemi | C52917434 | LCSC
13 | 1 | !Ä-OLED-0.9 1-12832-I2C -SSD1306 | OLED | MOULD-OLED-0.91-12832-I2C-SSD1306
14 | 1 | S9013 | Q1 | SOT-23-3_L2 .9-W1.4-P1. 90-LS2.6-BR | | S9013 | CBI(ú) | C2836092 | LCSC
15 | 2 | 5.1K | R1,R2 | R0603 | 5.1K
16 | 3 | 0© | R3,R4,R5 | R0603 | 0©
17 | 2 | 4.7K | R6,R7 | R0603 | 4.7K
18 | 6 | 10K | R8,R11,R12,R14,R17,R19 | R0603 | 10K
19 | 2 | 100K | R9,R15 | R0603 | 100K
20 | 1 | 1K | R10 | R0603 | 1K
21 | 1 | 100© | R13 | R0603 | 100©
22 | 1 | 2.4K | R20 | R0603 | 2.4K
23 | 1 | 20K | R21 | R0603 | 20K
24 | 1 | TA-3525-A1 | S | SW-SMD_3P-L 9.1-W3.5-P2 .50_BDKG-3P -H2MM | | TA-3525-A1 | Yuandi(Cê) | C514018 | LCSC
25 | 1 | TS35CA 250gf 031 | SW1 | KEY-SMD_TS3 5CA-250GF-0 31 | | TS35CA 250gf 031 | SHOU HAN(–é) | C39832523 | LCSC

26 | 1 | TP4056X-42-ESOP8 | U1 | SOP-8_L4.9-W3.9-P1.27-LS6.0-TL-EP | | TP4056X-42-ESOP8 | TOPPOWER(W¬) Tj | T* (Ó®) C2763448 | LCSC
27 | 1 | TLV75733PDB VR | U2 | SOT-23-5_L2 .9-W1.6-P0. 95-LS2.8-BL | | TLV75733PDB VR | TI(·Þêh) | C485517 | LCSC
28 | 1 | 2.4GHz | U3 | BULETM-SMD_ ESPRESSIF_E SP32-C3-WRO OM-02-N4-4M B | 2.4GHz | ESP32-C3-WR OOM-02-N4 | ESPRESSIF(P) Tj | T* (k) C2934560 | LCSC
29 | 2 | AO3401 | U5,U6 | SOT-23-3_L2 .9-W1.6-P1. 90-LS2.8-BR | | AO3401 | | C9900008520 LCSC
30 | 1 | TYPE-C | USB0 | USB-SMD_TYP EC-304A-ACP 16O | | TYPE-C | XUNPU(¯n) | C2909610 | LCSC

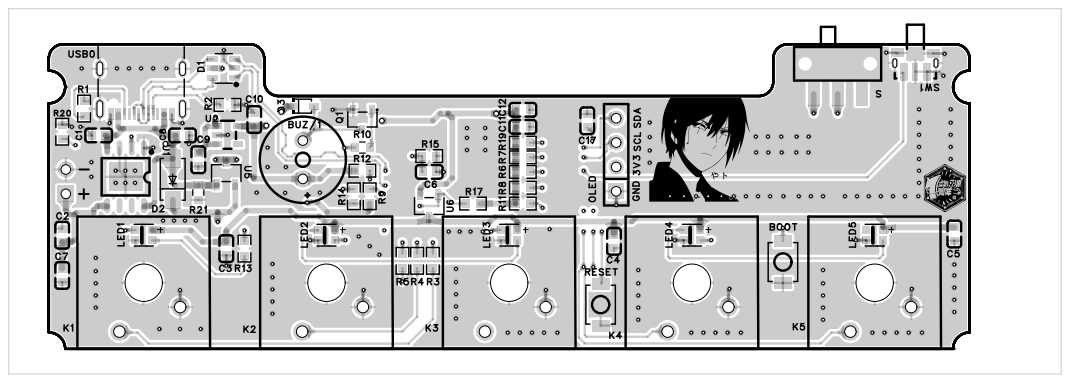
[picture p10: page 5]

BOOT

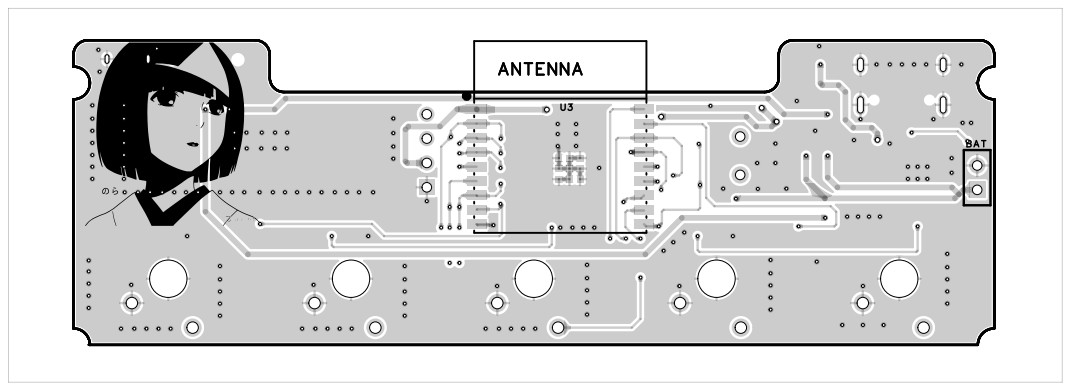
[picture p11: page 6]

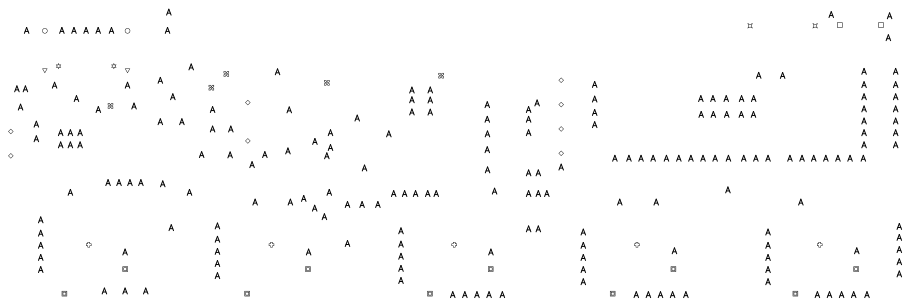
[picture p12: page 7]
