flystar233/keyborad/include/display_font.h

// ============================================================================
//  display_font.h - 6x8 ASCII 点阵字库 (字符 0x20..0x7E，共 95 个)
//
//  数据来源：从原工程 src/char.c 的 OLED_ASCII6x8[][] 程序化提取并展平，
//  每个字符 6 字节，低位在上 (LSB = 顶部像素)，对应 SSD1306 页寻址模式。
//  每字节 = 一列的 8 个像素，bit0 在最上面。
// ============================================================================
#pragma once
#include <stdint.h>

#define FONT_W 6
#define FONT_H 8
#define FONT_FIRST 0x20
#define FONT_LAST  0x7E
#define FONT_CHARS (FONT_LAST - FONT_FIRST + 1)

static const uint8_t FONT6X8[FONT_CHARS][FONT_W] = {
    { 0x00, 0x00, 0x00, 0x00, 0x00, 0x00 },  // 0x20 'sp'
    { 0x00, 0x00, 0x00, 0x2F, 0x00, 0x00 },  // 0x21 '!'
    { 0x00, 0x00, 0x07, 0x00, 0x07, 0x00 },  // 0x22 '"'
    { 0x00, 0x14, 0x7F, 0x14, 0x7F, 0x14 },  // 0x23 '#'
    { 0x00, 0x24, 0x2A, 0x7F, 0x2A, 0x12 },  // 0x24 '$'
    { 0x00, 0x23, 0x13, 0x08, 0x64, 0x62 },  // 0x25 '%'
    { 0x00, 0x36, 0x49, 0x55, 0x22, 0x50 },  // 0x26 '&'
    { 0x00, 0x00, 0x00, 0x07, 0x00, 0x00 },  // 0x27 '''
    { 0x00, 0x00, 0x1C, 0x22, 0x41, 0x00 },  // 0x28 '('
    { 0x00, 0x00, 0x41, 0x22, 0x1C, 0x00 },  // 0x29 ')'
    { 0x00, 0x14, 0x08, 0x3E, 0x08, 0x14 },  // 0x2A '*'
    { 0x00, 0x08, 0x08, 0x3E, 0x08, 0x08 },  // 0x2B '+'
    { 0x00, 0x00, 0x00, 0xA0, 0x60, 0x00 },  // 0x2C ','
    { 0x00, 0x08, 0x08, 0x08, 0x08, 0x08 },  // 0x2D '-'
    { 0x00, 0x00, 0x60, 0x60, 0x00, 0x00 },  // 0x2E '.'
    { 0x00, 0x20, 0x10, 0x08, 0x04, 0x02 },  // 0x2F '/'
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
    { 0x00, 0x44, 0x64, 0x54, 0x4C, 0x44 },  // 0x7A 'z'
    { 0x00, 0x00, 0x08, 0x7F, 0x41, 0x00 },  // 0x7B '{'
    { 0x00, 0x00, 0x00, 0x7F, 0x00, 0x00 },  // 0x7C '|'
    { 0x00, 0x00, 0x41, 0x7F, 0x08, 0x00 },  // 0x7D '}'
    { 0x00, 0x08, 0x04, 0x08, 0x10, 0x08 },  // 0x7E '~'
};
