flystar233/keyborad/(commit log)

2026-10-11 Update print statement from 'Hello' to 'Goodbye'
2026-10-11 Update fmt.Println message from 'Hello' to 'Goodbye'
